rodneyosodo/subira/kicad/schematic.pdf

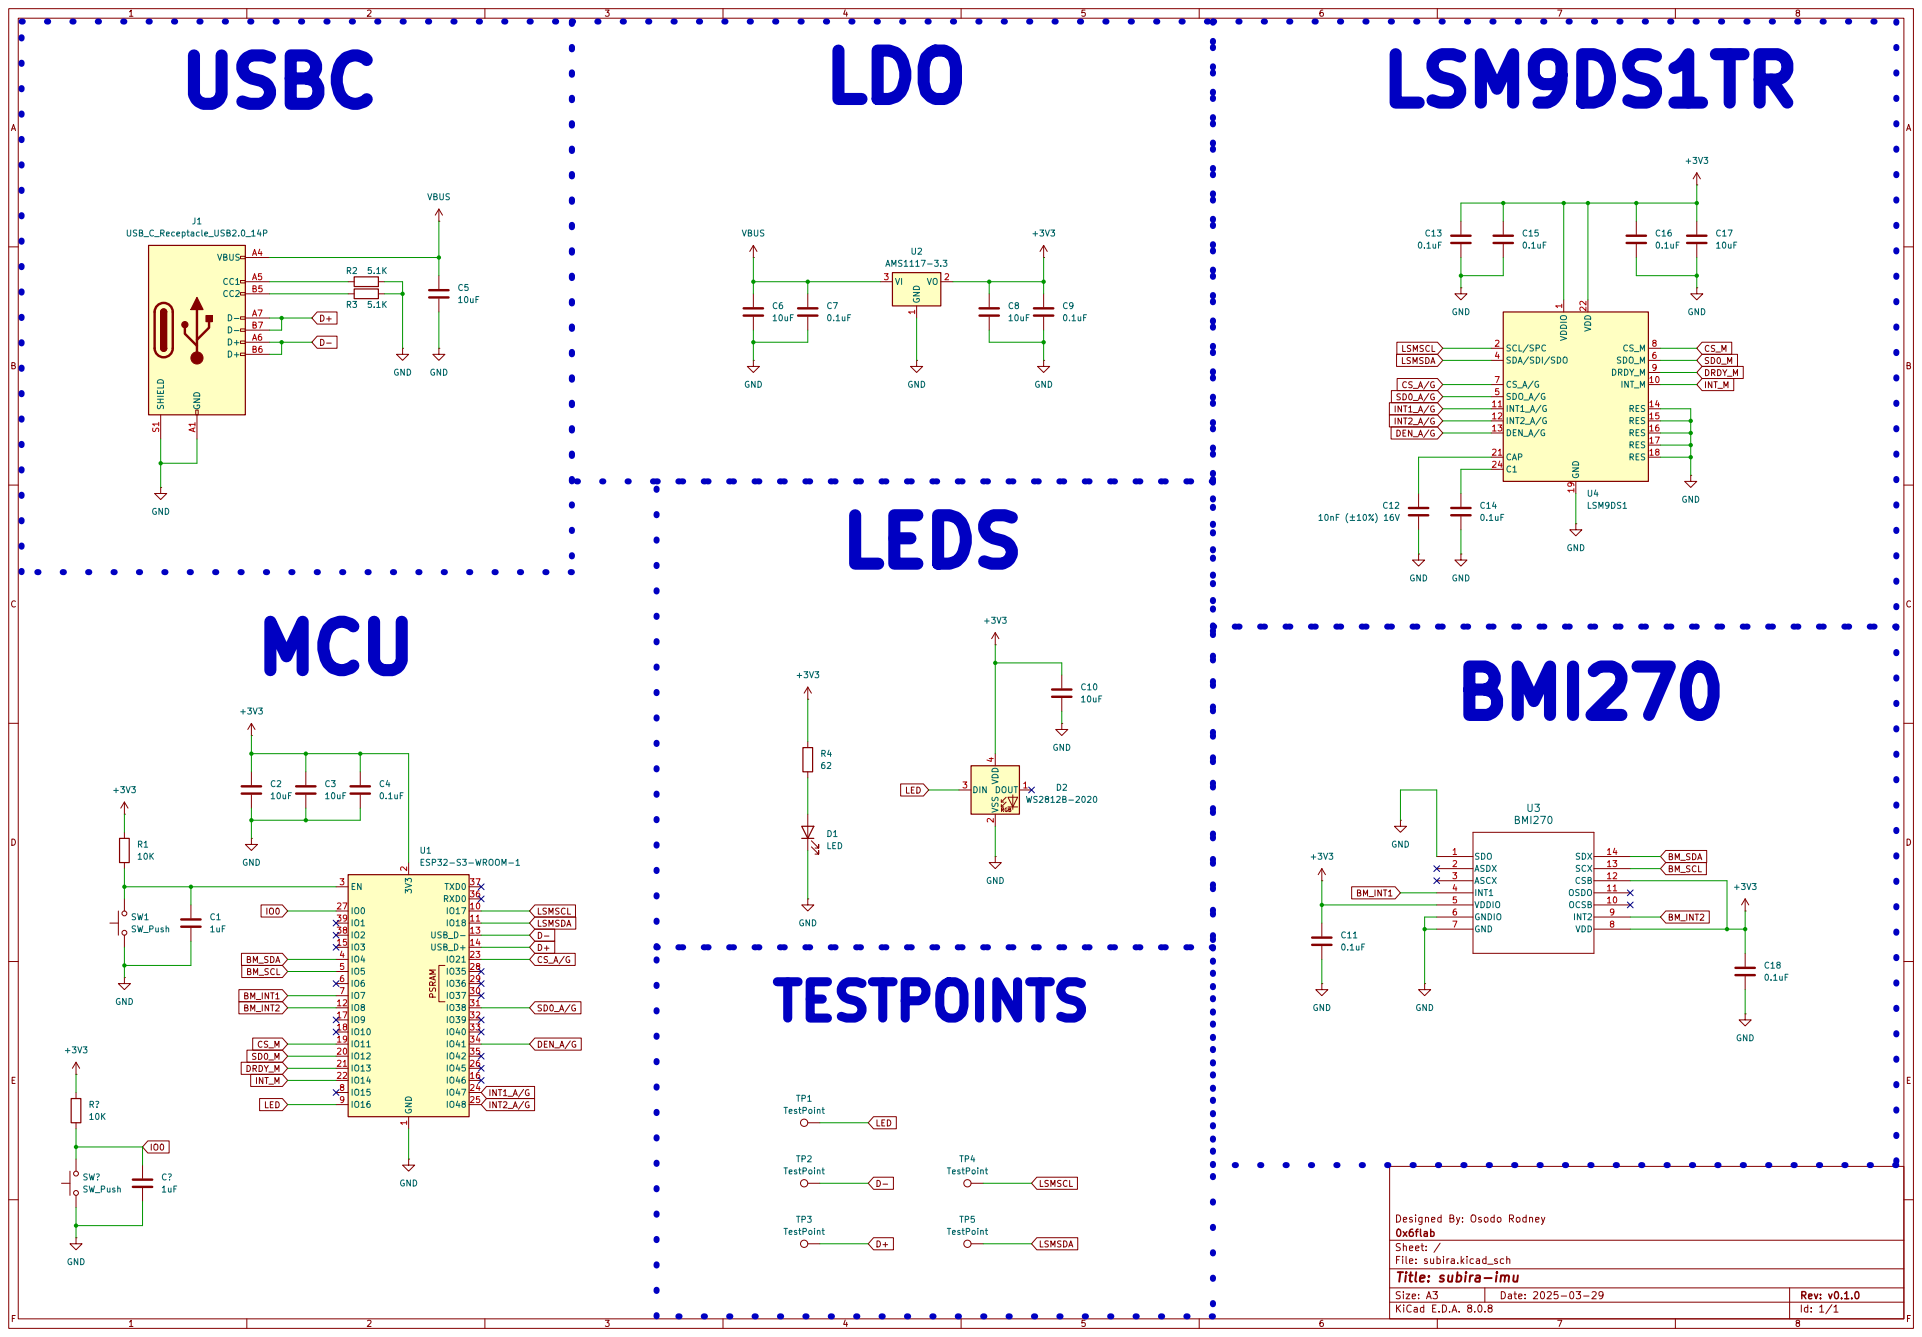
[picture p1: page 1]
