rodneyosodo/subira/kicad/subira.kicad_pcb

## KiCad design kicad/subira.kicad_pcb (2025-04-06)

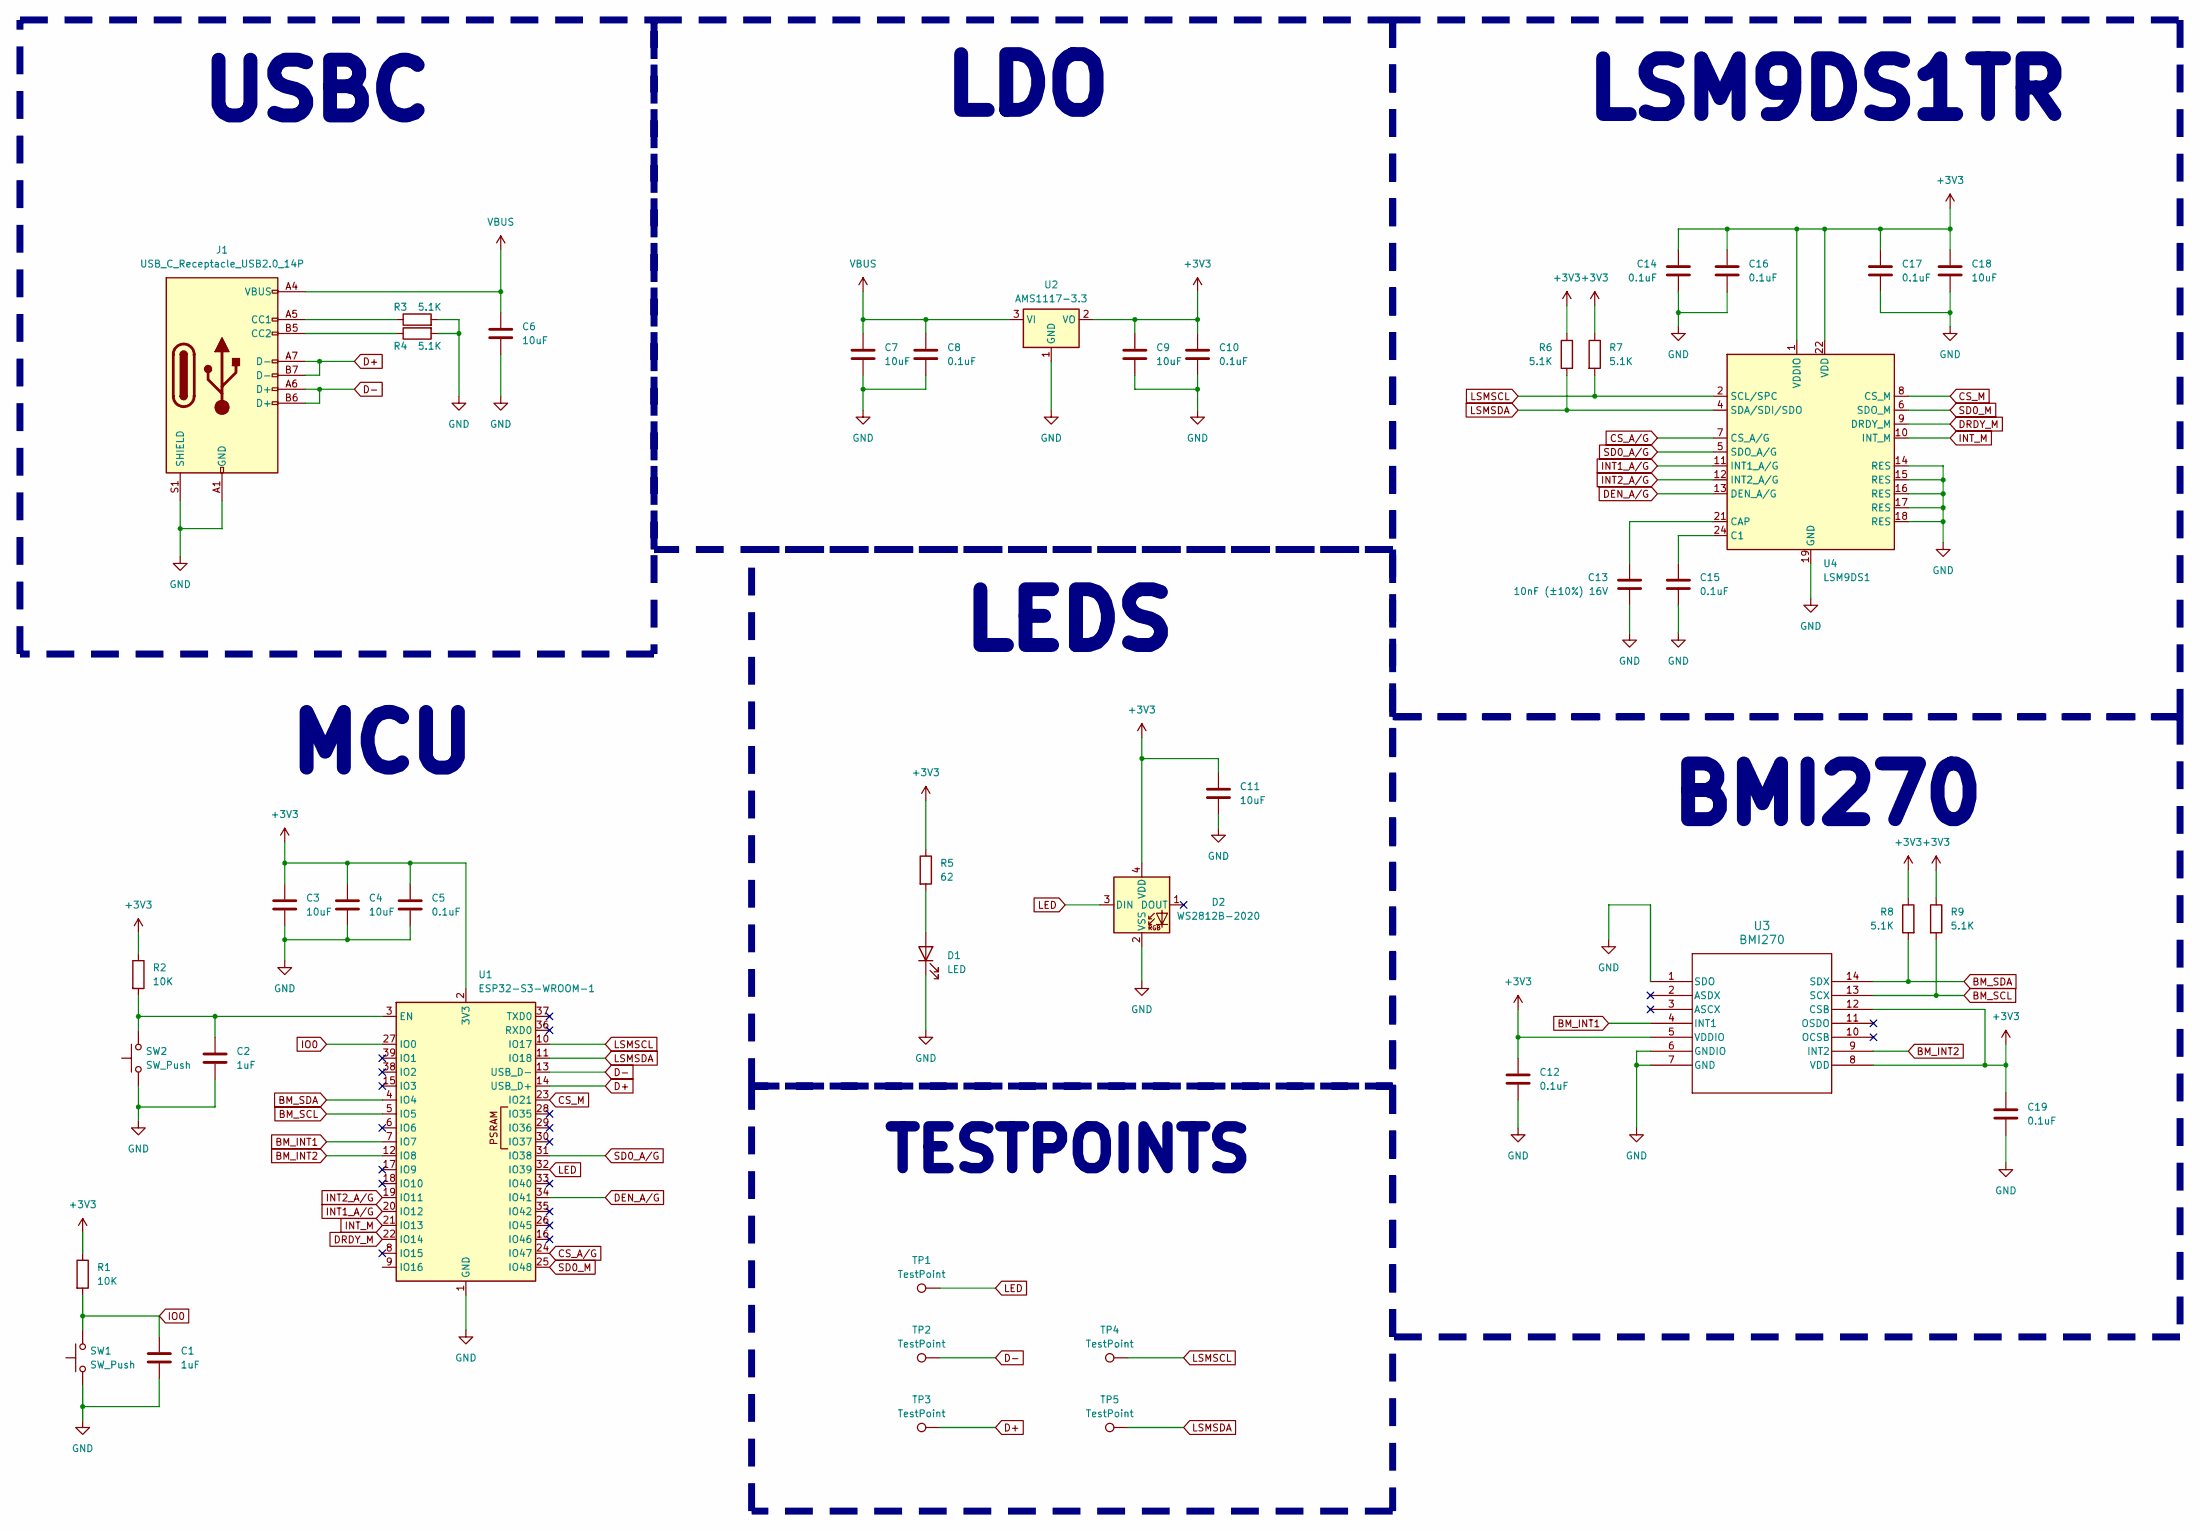
[picture p2: schematic subira.kicad_sch, subira-imu]

Parts:
C1, C2: 1uF; C_0603_1608Metric_Pad1.08x0.95mm_HandSolder; JLCPCB C15849
C3, C4, C6, C7, C9, C11, C18: 10uF; C_0603_1608Metric_Pad1.08x0.95mm_HandSolder; JLCPCB C96446
C5, C8, C10, C12, C14, C15, C16, C17, C19: 0.1uF; C_0603_1608Metric_Pad1.08x0.95mm_HandSolder; JLCPCB C88136
C13: 10nF (±10%) 16V; C_0603_1608Metric_Pad1.08x0.95mm_HandSolder; JLCPCB C57112
D1: LED; LED_0603_1608Metric; JLCPCB C2290
D2: WS2812B-2020; LED_WS2812B-2020_PLCC4_2.0x2.0mm; JLCPCB C965555
J1: USB_C_Receptacle_USB2.0_14P; USB_C_Receptacle_G-Switch_GT-USB-7010ASV; JLCPCB C393939
R1, R2: 10K; R_0603_1608Metric_Pad0.98x0.95mm_HandSolder; JLCPCB C25804
R3, R4, R6, R7, R8, R9: 5.1K; R_0603_1608Metric_Pad0.98x0.95mm_HandSolder; JLCPCB C23186
R5: 62; R_0603_1608Metric_Pad0.98x0.95mm_HandSolder; JLCPCB C23222
SW1, SW2: SW_Push; SW_Push_SPST_NO_Alps_SKRK; JLCPCB C720477
TP1, TP2, TP3, TP4, TP5: TestPoint; TestPoint_Pad_D2.0mm
U1: ESP32-S3-WROOM-1; JLCPCB C2913197
U2: AMS1117-3.3; SOT-223-3_TabPin2; JLCPCB C6186
U3: BMI270; BMI270_BOS-M; JLCPCB C2836813
U4: LSM9DS1; LGA-24L_3x3.5mm_P0.43mm; JLCPCB C2655096

Connections:
+3V3: C3.1, C4.1, C5.1, C9.1, C10.1, C11.1, C12.1, C14.1, C16.1, C17.1, C18.1, C19.1, D2.4 (VDD), R1.1, R2.1, R5.1, R6.1, R7.1, R8.1, R9.1, U1.2 (3V3), U2.2 (VO), U3.5 (VDDIO), U3.8 (VDD), U3.12 (CSB), U4.1 (VDDIO), U4.3 (VDDIO), U4.22 (VDD), U4.23 (VDD)
BM_INT1: U1.7 (IO7), U3.4 (INT1)
BM_INT2: U1.12 (IO8), U3.9 (INT2)
BM_SCL: R9.2, U1.5 (IO5), U3.13 (SCX)
BM_SDA: R8.2, U1.4 (IO4), U3.14 (SDX)
CS_A/G: U1.24 (IO47), U4.7 (CS_A/G)
CS_M: U1.23 (IO21), U4.8 (CS_M)
D+: J1.A7 (D-), J1.B7 (D-), TP3.1, U1.14 (USB_D+)
D-: J1.A6 (D+), J1.B6 (D+), TP2.1, U1.13 (USB_D-)
DEN_A/G: U1.34 (IO41), U4.13 (DEN_A/G)
DRDY_M: U1.22 (IO14), U4.9 (DRDY_M)
GND: C1.2, C2.2, C3.2, C4.2, C5.2, C6.2, C7.2, C8.2, C9.2, C10.2, C11.2, C12.2, C13.2, C14.2, C15.2, C16.2, C17.2, C18.2, C19.2, D1.1 (K), D2.2 (VSS), J1.A1 (GND), J1.A12 (GND), J1.B1 (GND), J1.B12 (GND), J1.S1 (SHIELD), R3.2, R4.2, SW1.1, SW2.1, U1.1 (GND), U1.40 (GND), U1.41 (GND), U2.1 (GND), U3.1 (SDO), U3.6 (GNDIO), U3.7 (GND), U4.14 (RES), U4.15 (RES), U4.16 (RES), U4.17 (RES), U4.18 (RES), U4.19 (GND), U4.20 (GND)
INT1_A/G: U1.20 (IO12), U4.11 (INT1_A/G)
INT2_A/G: U1.19 (IO11), U4.12 (INT2_A/G)
INT_M: U1.21 (IO13), U4.10 (INT_M)
IO0: C1.1, R1.2, SW1.2, U1.27 (IO0)
LED: D2.3 (DIN), TP1.1, U1.32 (IO39)
LSMSCL: R7.2, TP4.1, U1.10 (IO17), U4.2 (SCL/SPC)
LSMSDA: R6.2, TP5.1, U1.11 (IO18), U4.4 (SDA/SDI/SDO)
unnamed: D1.2 (A), R5.2
unnamed: J1.A5 (CC1), R3.1
unnamed: J1.B5 (CC2), R4.1
unnamed: C2.1, R2.2, SW2.2, U1.3 (EN)
unnamed: C15.1, U4.24 (C1)
unnamed: C13.1, U4.21 (CAP)
SD0_A/G: U1.31 (IO38), U4.5 (SDO_A/G)
SD0_M: U1.25 (IO48), U4.6 (SDO_M)
VBUS: C6.1, C7.1, C8.1, J1.A4 (VBUS), J1.A9 (VBUS), J1.B4 (VBUS), J1.B9 (VBUS), U2.3 (VI)

Notes on the sheet:
LSM9DS1TR
MCU
TESTPOINTS
BMI270
LDO
LEDS
USBC

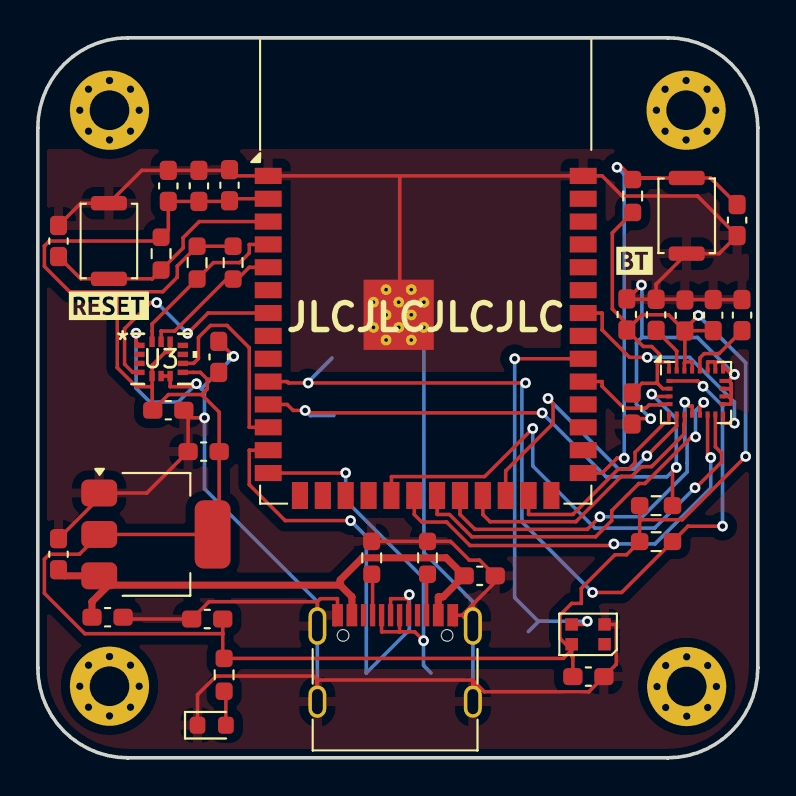
[picture p3: board subira.kicad_pcb from above]

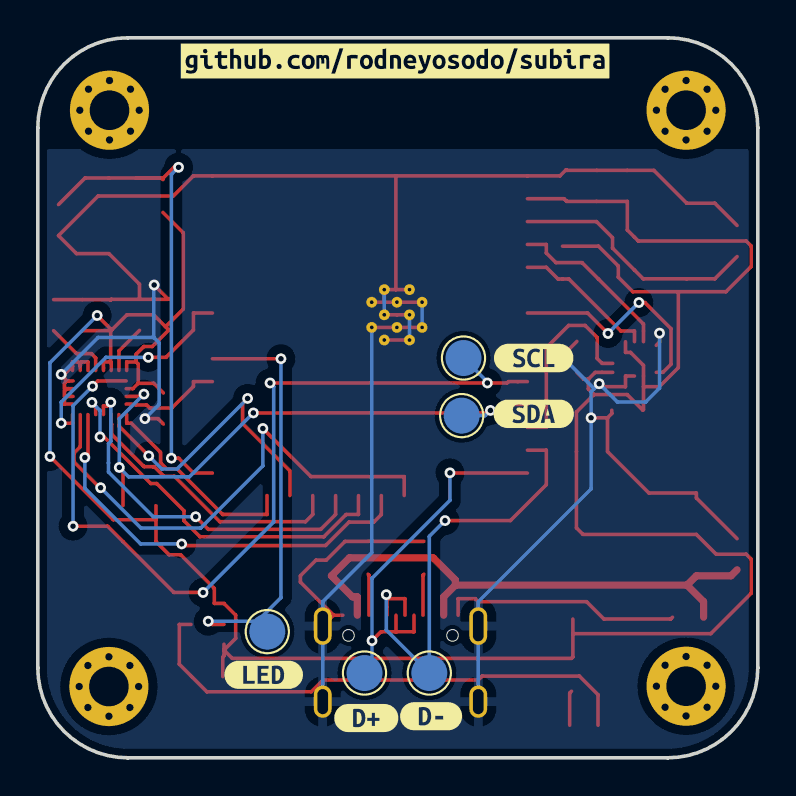
[picture p4: board subira.kicad_pcb from below]

Board: 2 copper layers, 40.0 x 40.0 mm, 54 parts (11 on the bottom side), 28 nets.

Other parts of the board:
REF1, REF2, REF3, REF4: MountingHole_2.2mm_M2_Pad_Via
kibuzzard-67E8F709: G***; kibuzzard-67E8F709
kibuzzard-67E8F774: G***; kibuzzard-67E8F774
kibuzzard-67E73E58: G***; kibuzzard-67E73E58
kibuzzard-67E73E61: G***; kibuzzard-67E73E61
kibuzzard-67E73E95: G***; kibuzzard-67E73E95
kibuzzard-67E73EA2: G***; kibuzzard-67E73EA2
kibuzzard-67E73EAE: G***; kibuzzard-67E73EAE
kibuzzard-67E73F75: G***; kibuzzard-67E73F75
