rodneyosodo/subira/(threads)

Thread 1 (2025-03-29):

Re-order the decoupling caps in your routing

kimanimichael, 2025-03-29:
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

The decoupling caps should match what is in the schematic as much as possible.

Pin 1 should connect directly to C15 (.1uF) and then to GND. In your routing, pin 1 connects to C17(10uF) which should be the bulk decoupling capacitor for pin 22 as per your schematic.

kimanimichael, 2025-03-29:
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

Same for your BMI270.
Ensure your decoupling caps are connected to the right pins. e.g C18 is meant to decouple pin 8 of the aforementioned module but is not routed that way.

Closed 2025-03-29.

Thread 2 (2025-03-29):

MCU flashing GPIO states

kimanimichael, 2025-03-29:
I am assuming you are planning to use the USB pins to download firmware to the chip.

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

From the datasheet, GPIO 46 and GPIO 0 should be in state 0 for this to work.

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

In the technical reference, GPIO 0 is usually high by default so this may cause an issue. My recommendation would be to add 2P header pins with circuitry(pull-down resistor) to give you an option to pull these pins down in hardware if need be.

Check this [Chip Boot Control](https://www.espressif.com/sites/default/files/documentation/esp32-s3_technical_reference_manual_en.pdf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) section.

Closed 2025-03-29.
