rodneyosodo/subira/(commit log)

2025-03-29 feat(kicad): Add schematic and PCB files for productions
    [bom.csv, designators.csv, positions.csv, subira.kicad_pcb, subira.kicad_sch]
2025-03-29 fix: enable usb boot option
    Fixes https://github.com/rodneyosodo/subira/issues/2
    Fixes https://github.com/rodneyosodo/subira/issues/1
    [bom.csv, designators.csv, positions.csv, subira.kicad_pcb, subira.kicad_sch]
2025-03-30 fix: add labels to RST and BOOT buttons
    [designators.csv, subira.kicad_pcb]
2025-04-06 fix(schematic): add 5.1K pull up resistors
    [bom.csv, designators.csv, positions.csv, subira.kicad_pcb, subira.kicad_sch]
